gavrd7/CFS-RFID-ESP32/docs/UPSTREAM_AND_LICENSE.md

# Upstream attribution and licensing status

The original Arduino foundation comes from [DnG-Crafts/K2-RFID](https://github.com/DnG-Crafts/K2-RFID). This repository retains code based on that project and other bundled third-party sources.

## Licence for original contributions

This project offers its **own original copyrightable contributions**, to the extent owned by the author, under **AGPL-3.0-only**. Read [LICENSE](../LICENSE) together with [LICENSE-SCOPE.md](../LICENSE-SCOPE.md). The scope includes original documentation and original enclosure geometry, but excludes inherited code, bundled third-party material and third-party logos/trademarks.

**This is not a blanket licence for the combined firmware.** Permission to distribute and modify the upstream code still requires an applicable upstream licence or express permission.

## Outstanding upstream checks

1. Confirm redistribution and modification permission for inherited DnG-Crafts Arduino source.
2. Identify any separately sourced printer-push agent code and its terms.
3. Trace bundled `src/AES/`, `src/MFRC522/`, any source-derived HTML/material records, and other third-party components to their licences, preserving relevant notices.
4. Verify the source and compatible version for external `libssh_esp32`.
5. Avoid implying Creality endorsement and check appropriate use of the name and logo in artwork, documentation and 3MF files.

The existence of a public GitHub repository does not itself grant an open-source licence for code without one.
