gavrd7/CFS-RFID-ESP32/images/tag-details.JPG

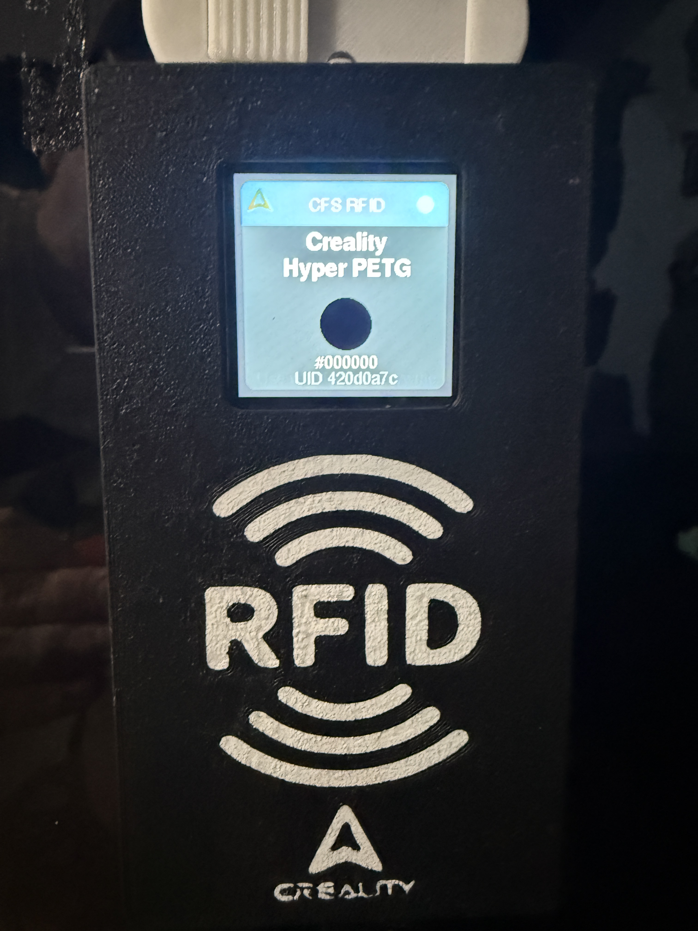
images/tag-details.JPG
