gavrd7/CFS-RFID-ESP32/images/tag-ready-to-write.JPG

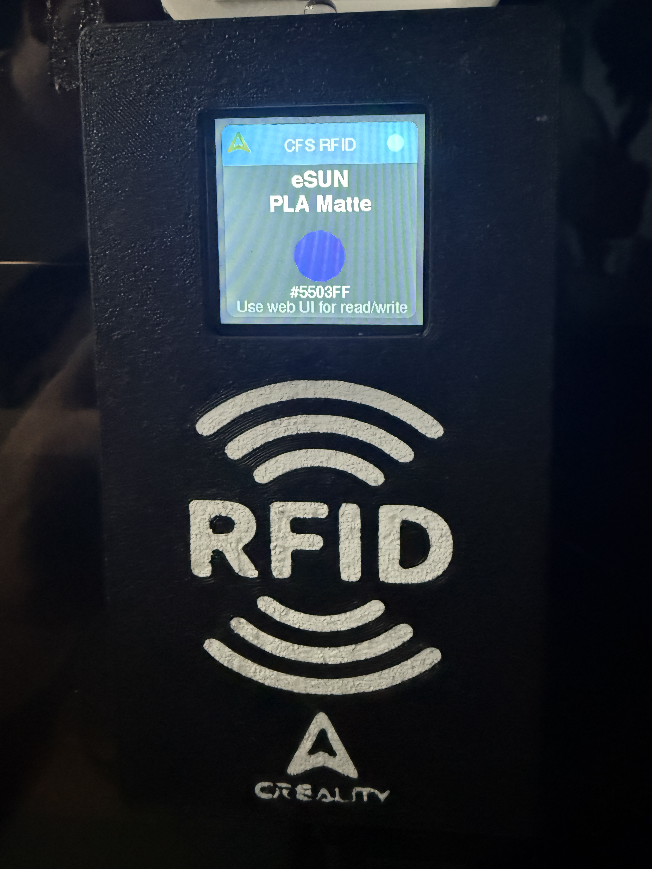
images/tag-ready-to-write.JPG
