gavrd7/CFS-RFID-ESP32/images/write-tag.JPG

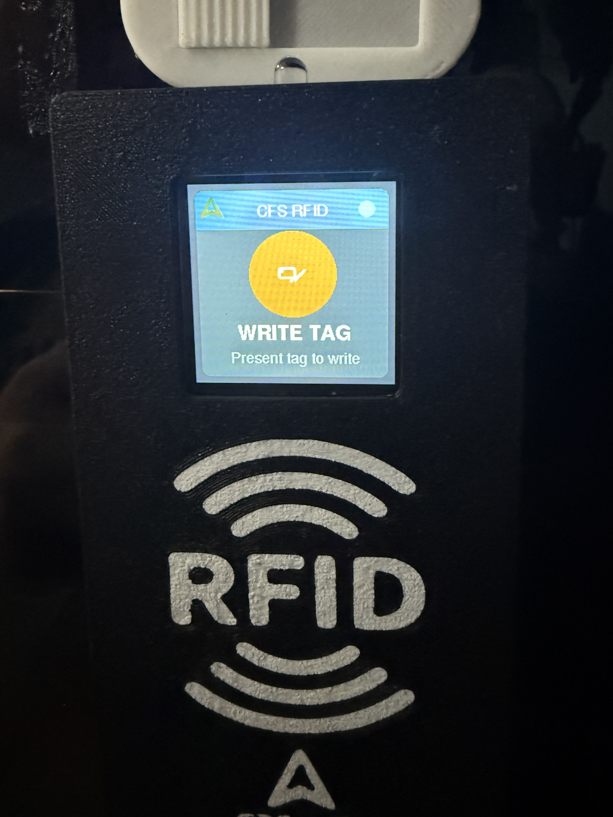
images/write-tag.JPG
