gavrd7/CFS-RFID-ESP32/screenshots/web-ui-custom-filaments-push.PNG

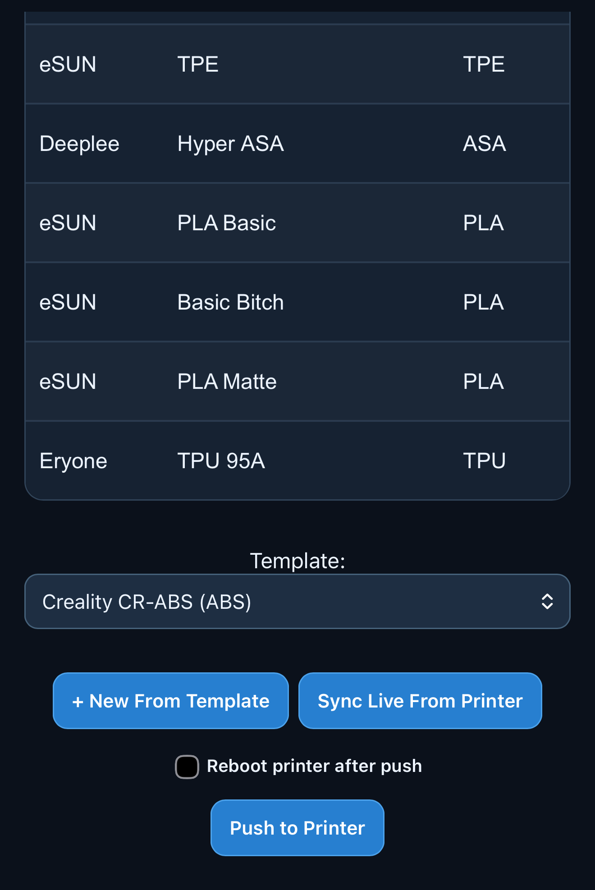
screenshots/web-ui-custom-filaments-push.PNG
