gavrd7/CFS-RFID-ESP32/screenshots/web-ui-network.PNG

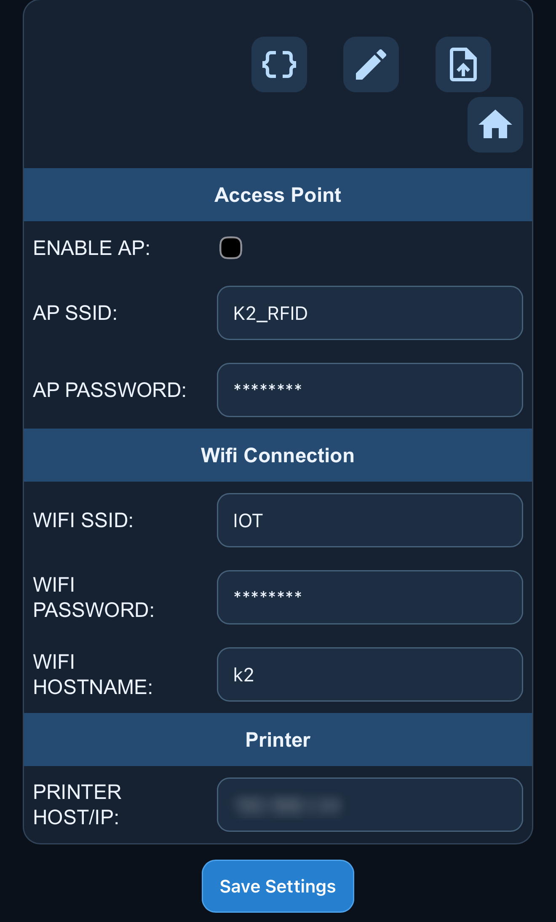
screenshots/web-ui-network.PNG
