gavrd7/CFS-RFID-ESP32/enclosure_stls/RFID with display.3mf

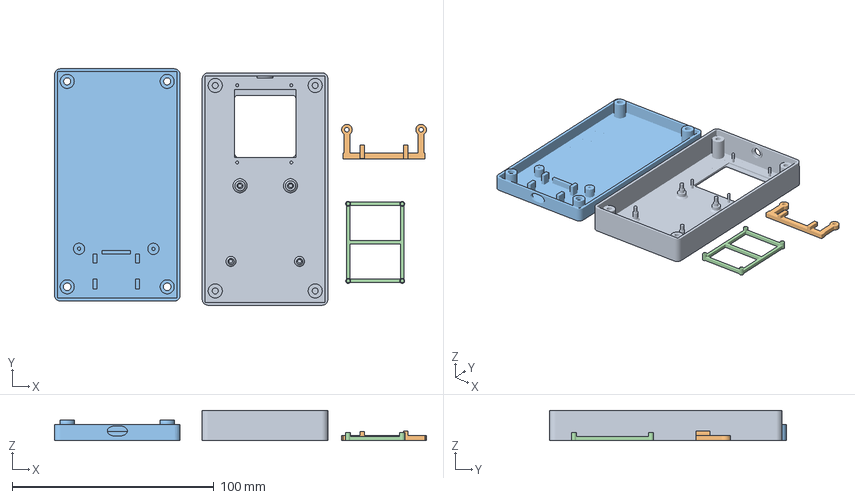
[picture p14: CAD file, 2026-10-27]
enclosure_stls/RFID with display.3mf
184.3 x 117.2 x 15.0 mm
Assembly
RFID with display - xiao secure.stl
RFID with display - back.stl
RFID with display - display secure.stl
