gavrd7/CFS-RFID-ESP32/enclosure_stls/RFID with display - display secure.stl

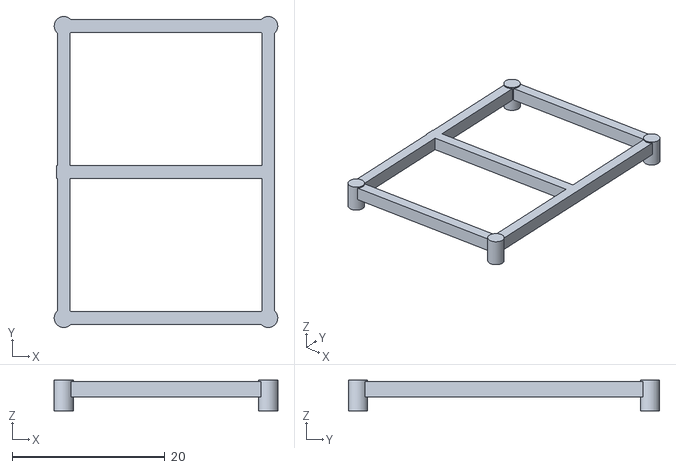
[picture p15: CAD file, 2026-10-26]
enclosure_stls/RFID with display - display secure.stl
29.3 x 40.7 x 4.00
