gavrd7/CFS-RFID-ESP32/enclosure_stls/RFID with display - xiao secure.stl

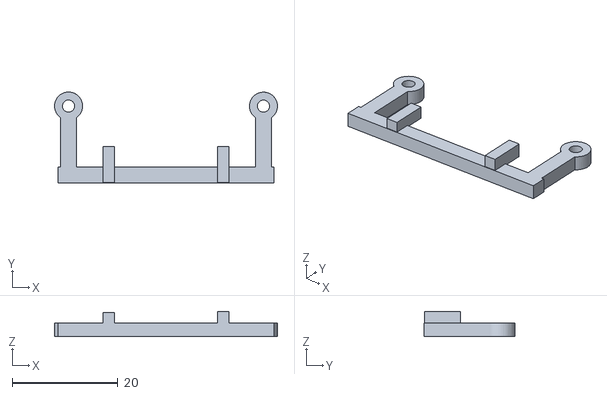
[picture p16: CAD file, 2026-10-26]
enclosure_stls/RFID with display - xiao secure.stl
42.1 x 17.2 x 4.80
