gavrd7/CFS-RFID-ESP32/enclosure_stls/RFID with display - back.stl

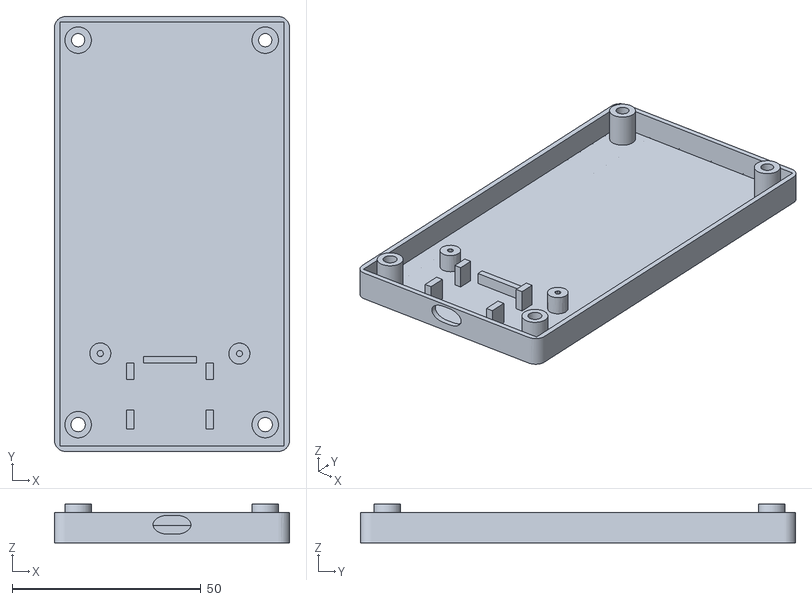
[picture p17: CAD file, 2026-10-26]
enclosure_stls/RFID with display - back.stl
62.3 x 115.2 x 10.2
