gavrd7/CFS-RFID-ESP32/enclosure_stls/RFID with display - front.stl

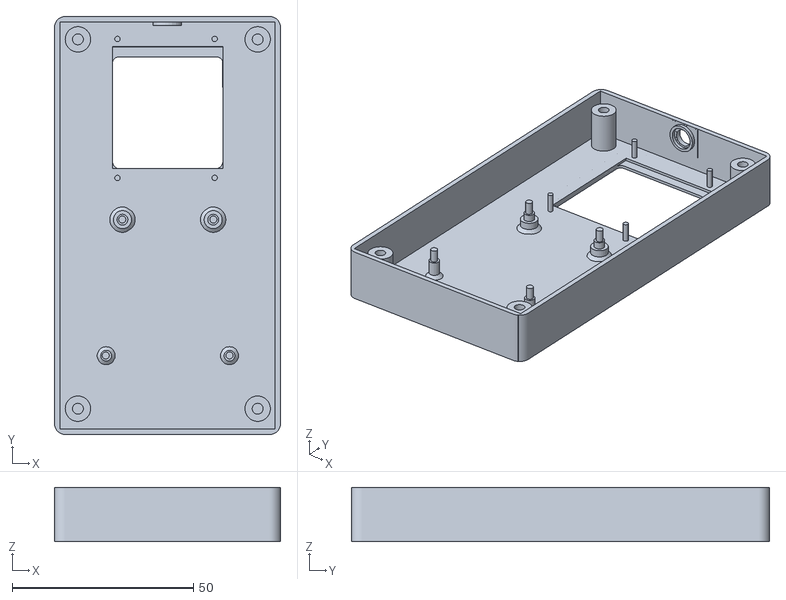
[picture p18: CAD file, 2026-10-26]
enclosure_stls/RFID with display - front.stl
62.3 x 115.2 x 15.0
