gavrd7/CFS-RFID-ESP32/enclosure_stls/RFID with display - text.stl

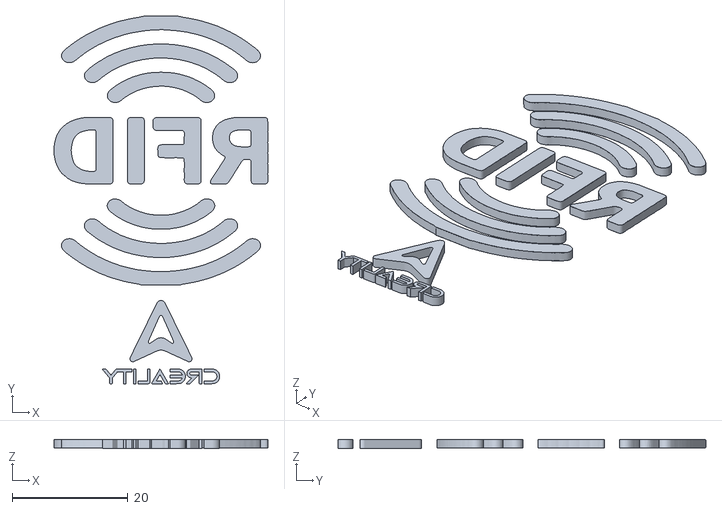
[picture p19: CAD file, 2026-10-26]
enclosure_stls/RFID with display - text.stl
37.0 x 63.5 x 1.49
