gavrd7/CFS-RFID-ESP32/images/custom-filament-printer-rfid.JPG

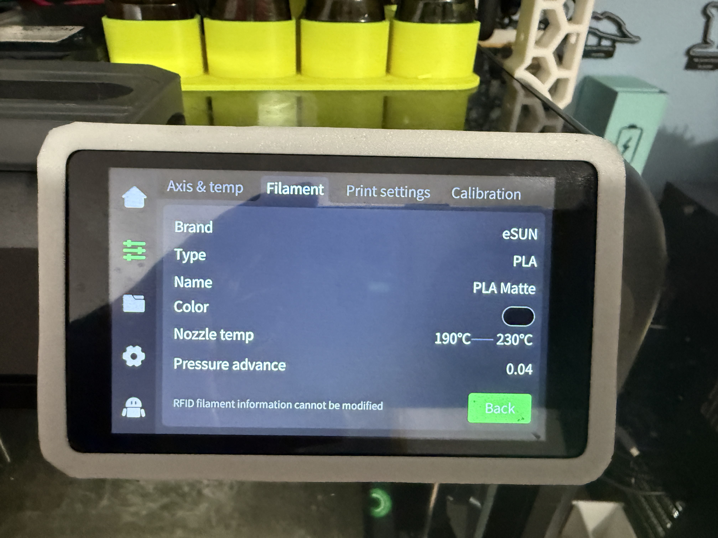
images/custom-filament-printer-rfid.JPG
