gavrd7/CFS-RFID-ESP32/images/custom-filaments-printer-screen.JPG

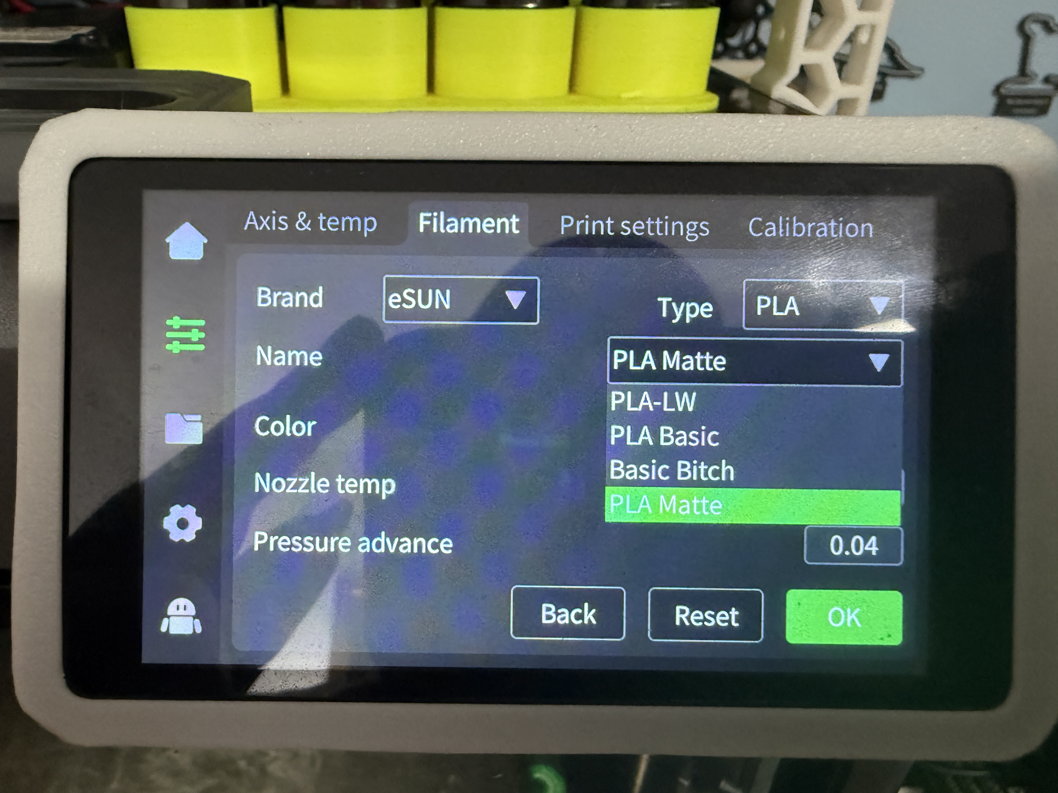
images/custom-filaments-printer-screen.JPG
