gavrd7/CFS-RFID-ESP32/images/printer-push.JPG

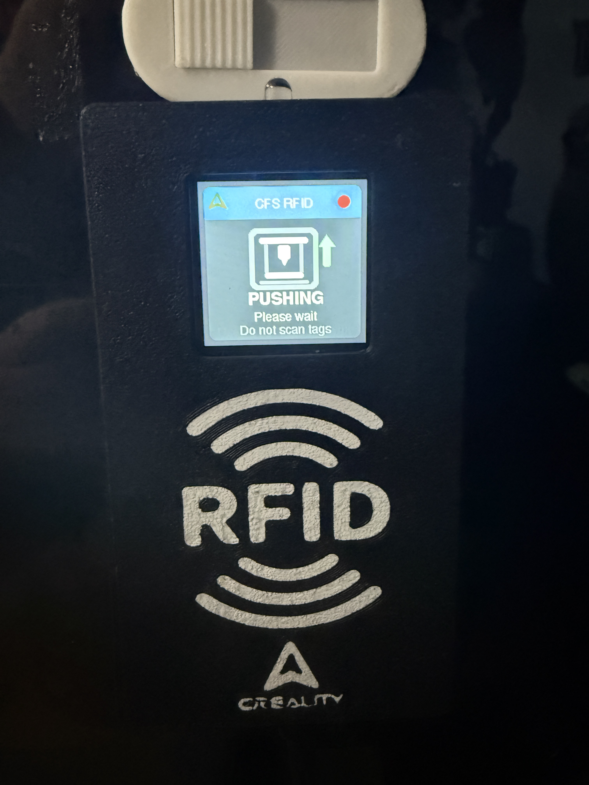
images/printer-push.JPG
