gavrd7/CFS-RFID-ESP32/images/printer-sync.JPG

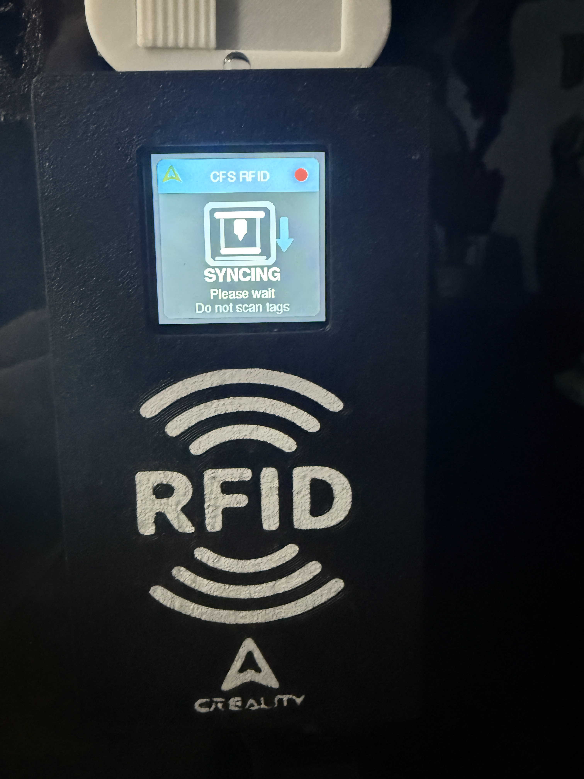
images/printer-sync.JPG
