gavrd7/CFS-RFID-ESP32/docs/history/README_v0.3.9_TEST.txt

CFS RFID XIAO C6 + TFT v0.3.9 TEST

Display-only refinement update based on the working v0.3.8 TEST firmware.

Changes in v0.3.9 TEST
- Restored the smaller mixed-case Home/ready footer text: "Use web UI for read/write"
- Kept UID footer display on passive and explicit tag-read screens
- Refined the read-tag icon so the outer scan wave matches the inner curves better
- Rebuilt the write-tag icon so it is better centred and scaled to match the read icon

Not changed
- Printer sync logic
- Printer push logic
- RFID read/write behaviour
- Local database/cache behaviour
- Web UI flow

Flash as normal over the existing test firmware.
