gavrd7/CFS-RFID-ESP32/docs/history/README_v0.3.7_TEST.txt

v0.3.7 TEST — TFT visual polish only. Changes: solid badges without rings; consistent FreeSans splash fonts; balanced header; larger brand text; spacing; shared tag icon with contactless-read or pencil-write; solid 3D-printer icon with down/up arrows. All database and printer transfer logic is unmodified from v0.3.6A. Compilation and physical tests not performed. Keep known working firmware as rollback.
