gavrd7/CFS-RFID-ESP32/firmware/CFS_RFID_XIAO_C6_TFT/cfs_action_icons.h

#pragma once
#include <Arduino.h>
// 66x66 anti-aliased, pre-rendered RGB565 icons on badge-colour backgrounds.
static const uint16_t CFS_READ_ICON_66[4356] PROGMEM = {
  0x2CBB, 0x2CBB, 0x2CBB, 0x2CBB, 0x2CBB, 0x2CBB, 0x2CBB, 0x2CBB, 0x2CBB, 0x2CBB, 0x2CBB, 0x2CBB, 0x2CBB, 0x2CBB, 0x2CBB, 0x2CBB,
  0x2CBB, 0x2CBB, 0x2CBB, 0x2CBB, 0x2CBB, 0x2CBB, 0x2CBB, 0x2CBB, 0x2CBB, 0x2CBB, 0x2CBB, 0x2CBB, 0x2CBB, 0x2CBB, 0x2CBB, 0x2CBB,
  0x2CBB, 0x2CBB, 0x2CBB, 0x2CBB, 0x2CBB, 0x2CBB, 0x2CBB, 0x2CBB, 0x2CBB, 0x2CBB, 0x2CBB, 0x2CBB, 0x2CBB, 0x2CBB, 0x2CBB, 0x2CBB,
  0x2CBB, 0x2CBB, 0x2CBB, 0x2CBB, 0x2CBB, 0x2CBB, 0x2CBB, 0x2CBB, 0x2CBB, 0x2CBB, 0x2CBB, 0x2CBB, 0x2CBB, 0x2CBB, 0x2CBB, 0x2CBB,
  0x2CBB, 0x2CBB, 0x2CBB, 0x2CBB, 0x2CBB, 0x2CBB, 0x2CBB, 0x2CBB, 0x2CBB, 0x2CBB, 0x2CBB, 0x2CBB, 0x2CBB, 0x2CBB, 0x2CBB, 0x2CBB,
  0x2CBB, 0x2CBB, 0x2CBB, 0x2CBB, 0x2CBB, 0x2CBB, 0x2CBB, 0x2CBB, 0x2CBB, 0x2CBB, 0x2CBB, 0x2CBB, 0x2CBB, 0x2CBB, 0x2CBB, 0x2CBB,
  0x2CBB, 0x2CBB, 0x2CBB, 0x2CBB, 0x2CBB, 0x2CBB, 0x2CBB, 0x2CBB, 0x2CBB, 0x2CBB, 0x2CBB, 0x2CBB, 0x2CBB, 0x2CBB, 0x2CBB, 0x2CBB,
  0x2CBB, 0x2CBB, 0x2CBB, 0x2CBB, 0x2CBB, 0x2CBB, 0x2CBB, 0x2CBB, 0x2CBB, 0x2CBB, 0x2CBB, 0x2CBB, 0x2CBB, 0x2CBB, 0x2CBB, 0x2CBB,
  0x2CBB, 0x2CBB, 0x2CBB, 0x2CBB, 0x2CBB, 0x2CBB, 0x2CBB, 0x2CBB, 0x2CBB, 0x2CBB, 0x2CBB, 0x2CBB, 0x2CBB, 0x2CBB, 0x2CBB, 0x2CBB,
  0x2CBB, 0x2CBB, 0x2CBB, 0x2CBB, 0x2CBB, 0x2CBB, 0x2CBB, 0x2CBB, 0x2CBB, 0x2CBB, 0x2CBB, 0x2CBB, 0x2CBB, 0x2CBB, 0x2CBB, 0x2CBB,
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
  0xFCA0, 0xFCA0, 0xFCA0, 0xFCA0, 0xFCA0, 0xFCA0, 0xFCA0, 0xFCA0, 0xFCA0, 0xFCA0, 0xFCA0, 0xFCA0, 0xFCA0, 0xFCA0, 0xFCA0, 0xFCA0,
  0xFCA0, 0xFCA0, 0xFCA0, 0xFCA0, 0xFCA0, 0xFCA0, 0xFCA0, 0xFCA0, 0xFCA0, 0xFCA0, 0xFCA0, 0xFCA0, 0xFCA0, 0xFCA0, 0xFCA0, 0xFCA0,
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
};
