gavrd7/CFS-RFID-ESP32/(commit log)

2026-10-26 docs: move upstream credit to introduction and explain enclosure assembly
2026-10-26 docs: expand first-time assembly Arduino setup and testing guide
2026-10-27 docs: warn against internet exposure of unauthenticated device services
