gavrd7/CFS-RFID-ESP32/images/rfid-printer.JPG

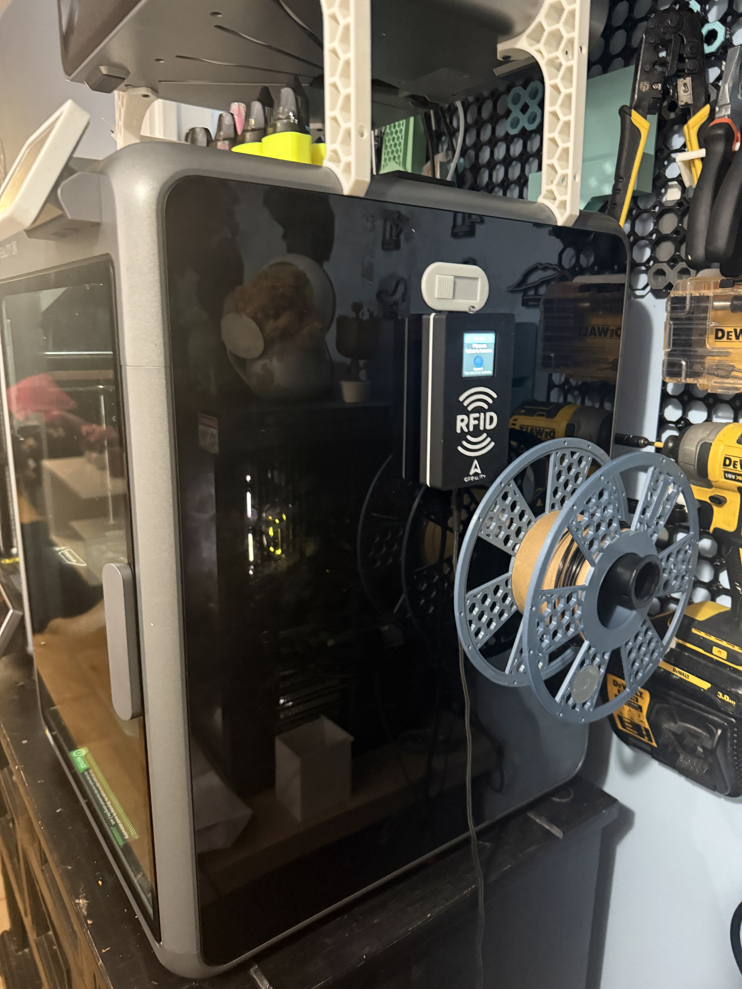
[picture p1: images/rfid-printer.JPG]
images/rfid-printer.JPG
