gavrd7/CFS-RFID-ESP32/images/home-screen.JPG

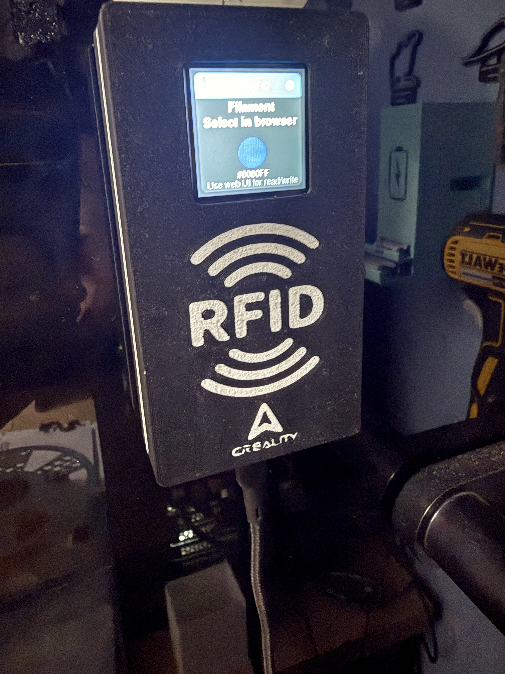
[picture p8: images/home-screen.JPG]
images/home-screen.JPG
